BanNT2002/2023B-20139062/FILE-BAO-CAO/Xac_Nhan_GVHD.jpg

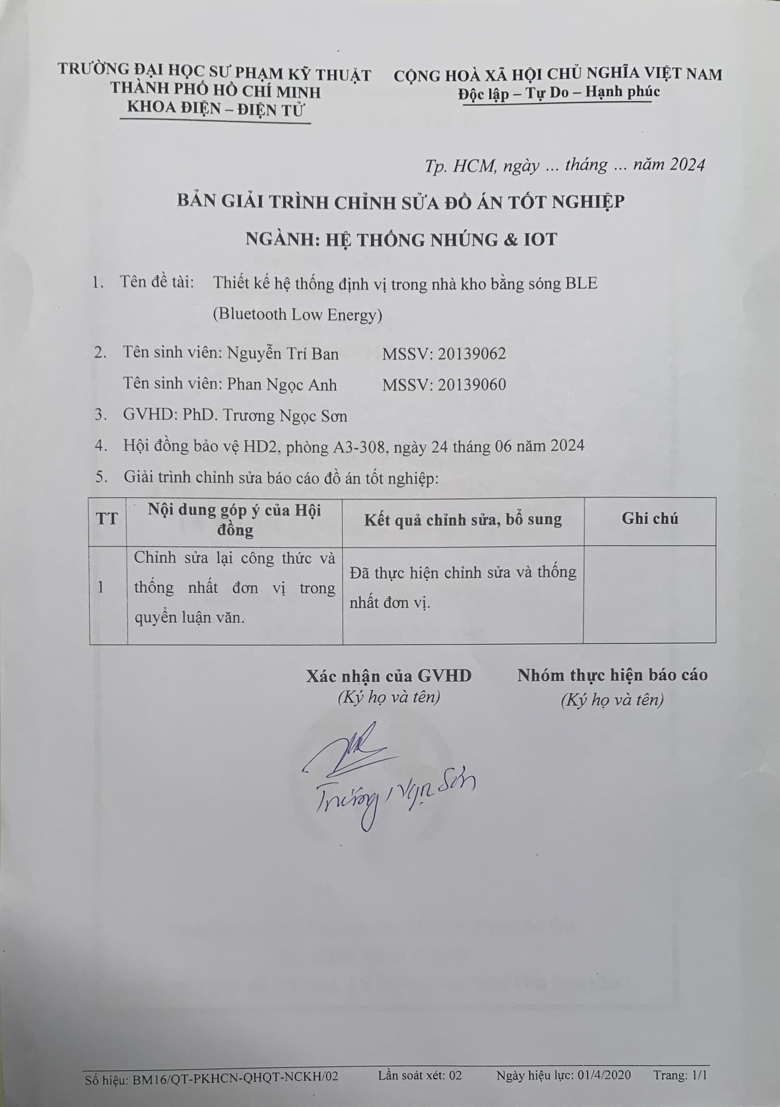
FILE-BAO-CAO/Xac_Nhan_GVHD.jpg
