BanNT2002/2023B-20139062/FILE-BAO-CAO/IN_DECAL.pptx

Cách BLE beacon tag: 20m

BLE gateway

ESP32 -1 | ESP32 -2
GPIO 16 | GPIO 17
GPIO 17 | GPIO 16
GND | GND
VCC: 5V DC

30m

BLE ibeacon

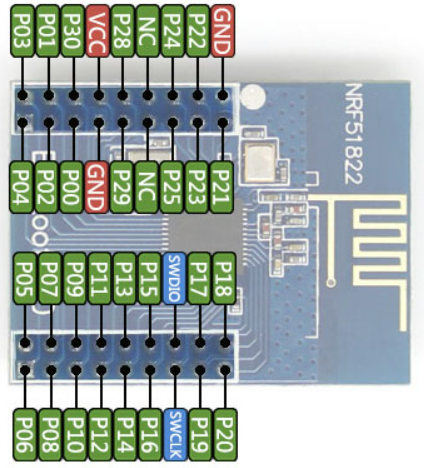
[picture p2: figure]

Normal

Khoảng cách tới:
BLE gateway: 20m
BLE ibeacon: 20-30m

No
charger

Charger

Save p

BLE beacon tag
