BanNT2002/2023B-20139062/HARDWARE/STL/ble_beacontag/ble_tag.stl

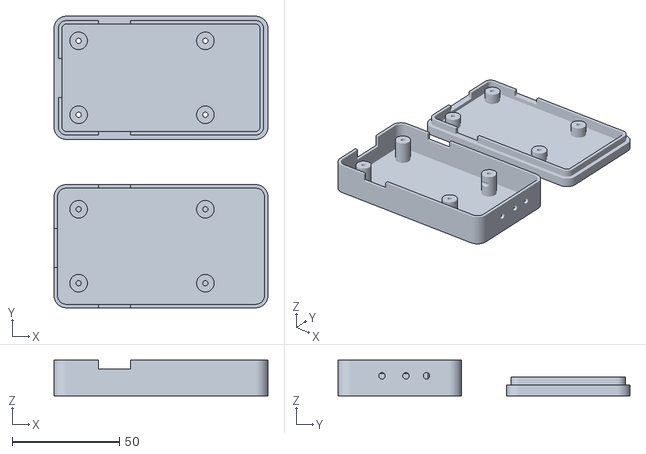
[picture p71: CAD file, 2024-07-18]
HARDWARE/STL/ble_beacontag/ble_tag.stl
99.8 x 135.9 x 16.7
