BanNT2002/2023B-20139062/HARDWARE/STL/ble_gateway/ble_gateway_top.stl

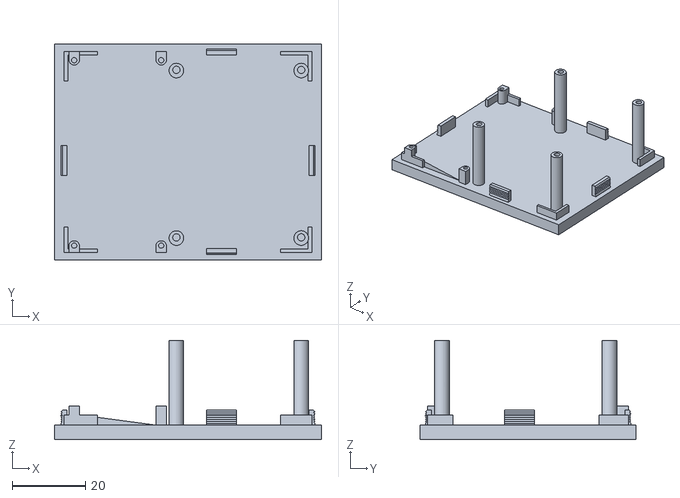
[picture p72: CAD file, 2024-07-18]
HARDWARE/STL/ble_gateway/ble_gateway_top.stl
73.0 x 59.0 x 27.2
