BanNT2002/2023B-20139062/HARDWARE/STL/ble_ibeacon/ibeacon.stl

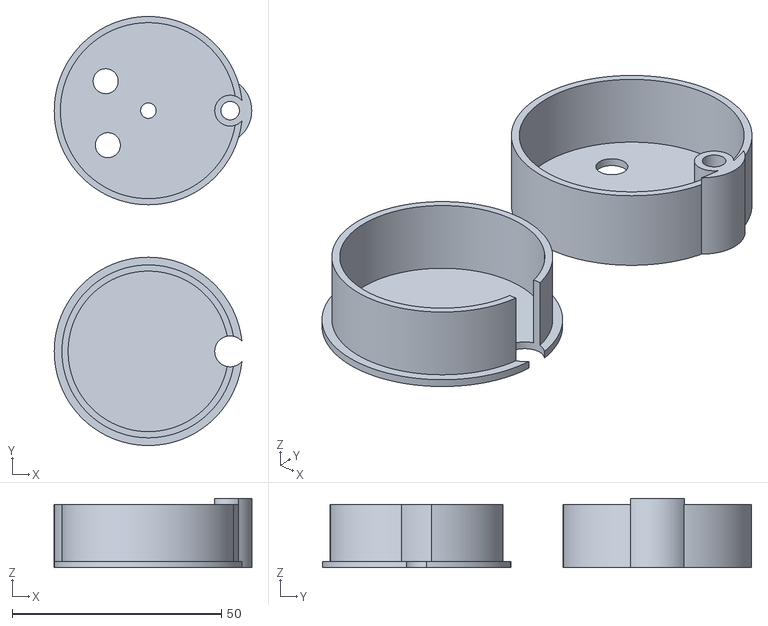
[picture p73: CAD file, 2024-07-18]
HARDWARE/STL/ble_ibeacon/ibeacon.stl
47.2 x 102.5 x 16.5
