BanNT2002/2023B-20139062/HARDWARE/STL/ble_gateway/Ble_gateway_buttom.stl

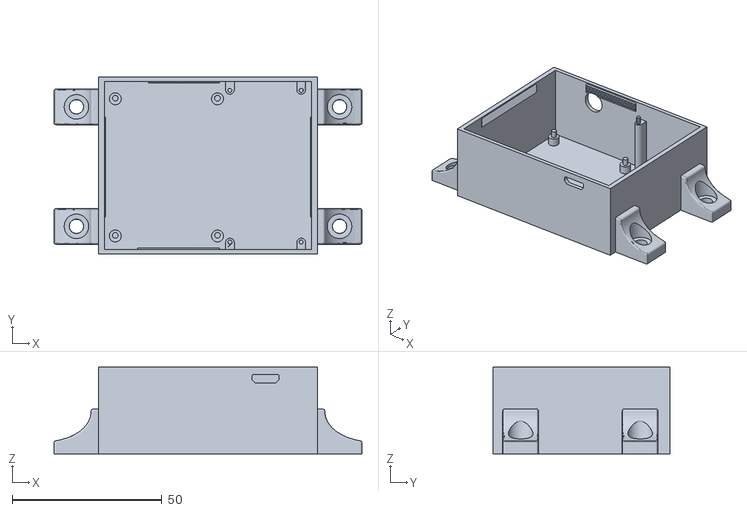
[picture p74: CAD file, 2024-07-18]
HARDWARE/STL/ble_gateway/Ble_gateway_buttom.stl
102.9 x 59.0 x 28.9
